MohamedFola/ADAS-Graduation-Project/STM32F103x pinout.jpeg

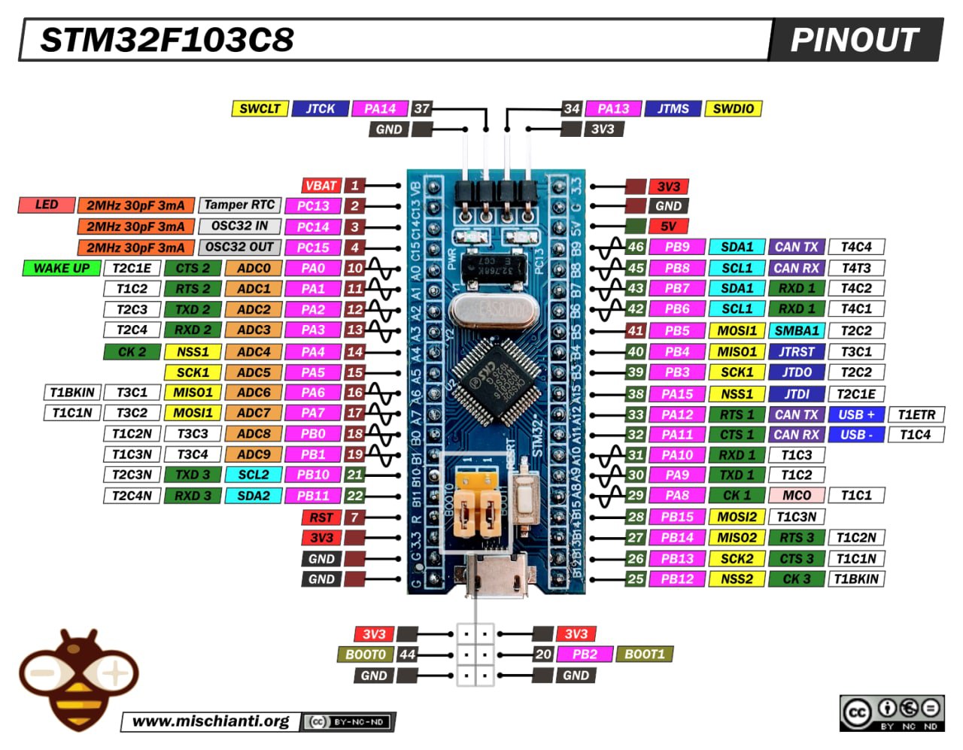
STM32F103x pinout.jpeg
