MohamedFola/ADAS-Graduation-Project/PCBs/Motion/Motion_board2.pdf

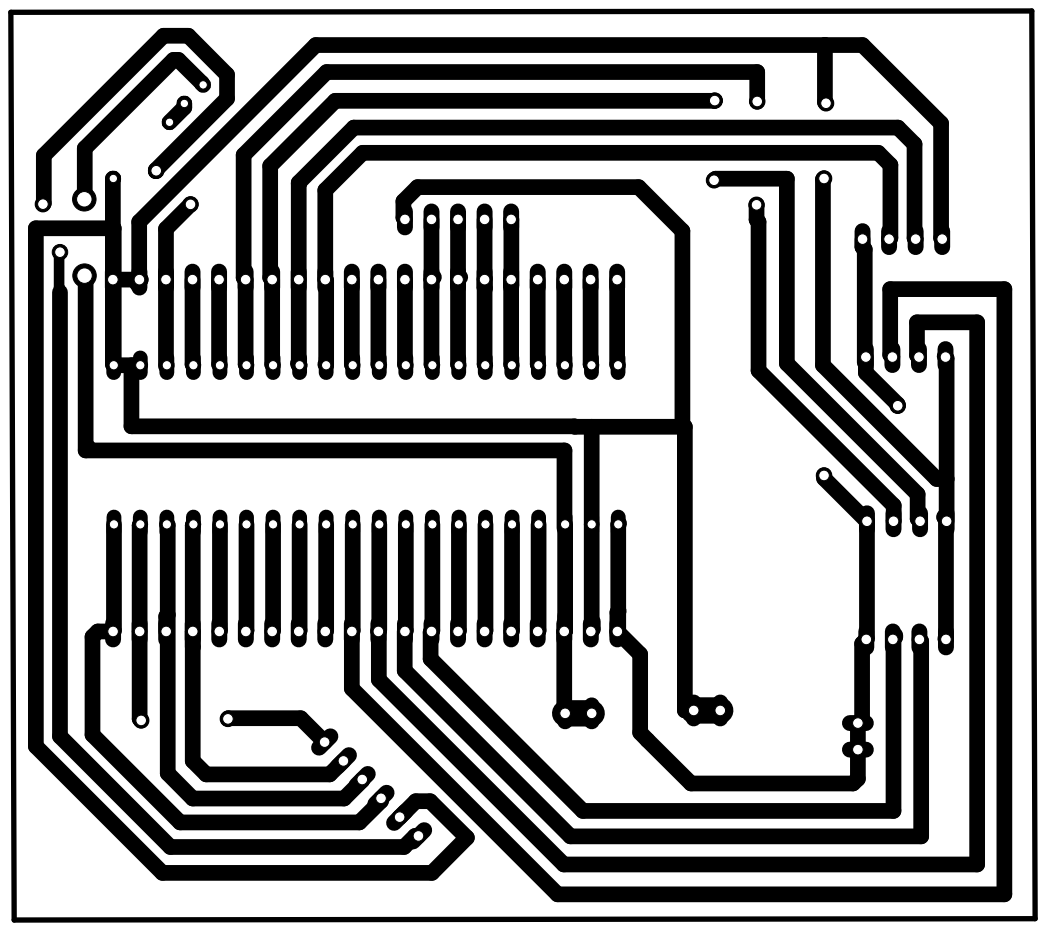
[picture p11: page 1]
