MohamedFola/ADAS-Graduation-Project/PCBs/Motion/Motion_sticker_2.pdf

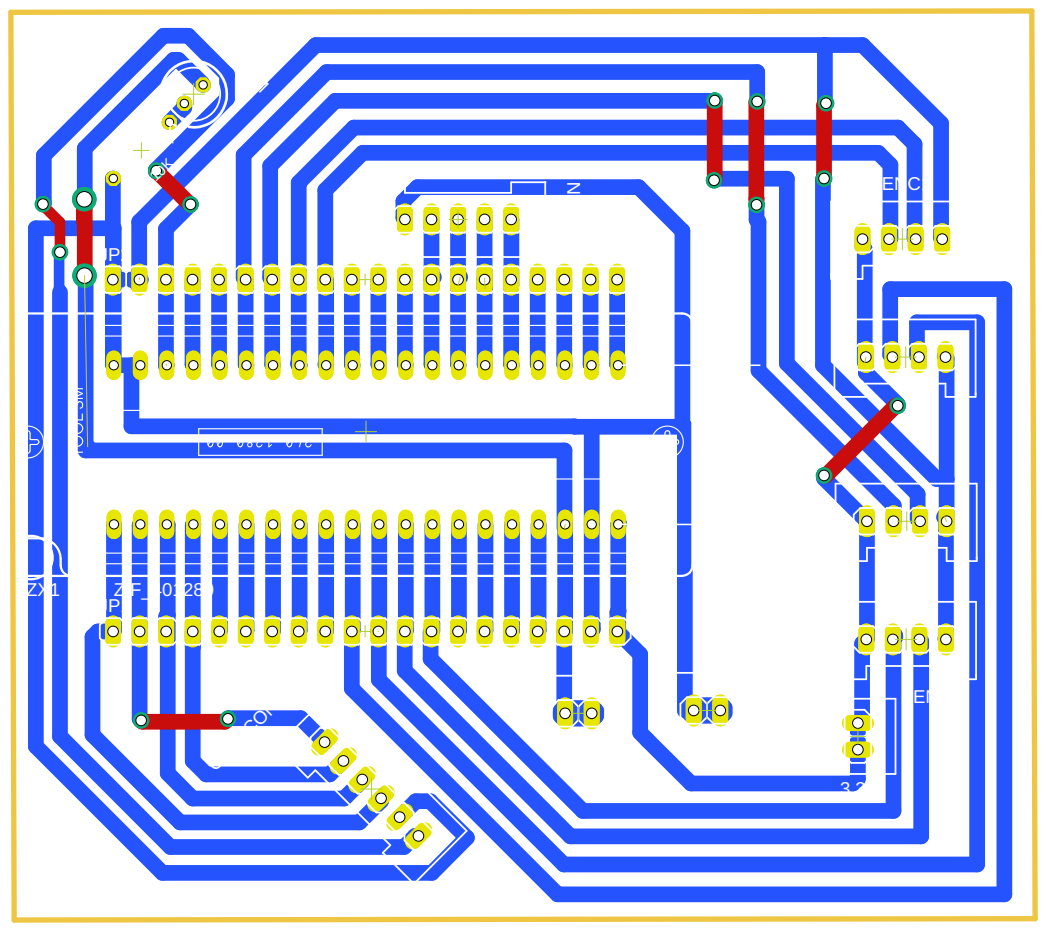
[picture p12: page 1]
