MohamedFola/ADAS-Graduation-Project/PCBs/Power1/Power_boarddd.pdf

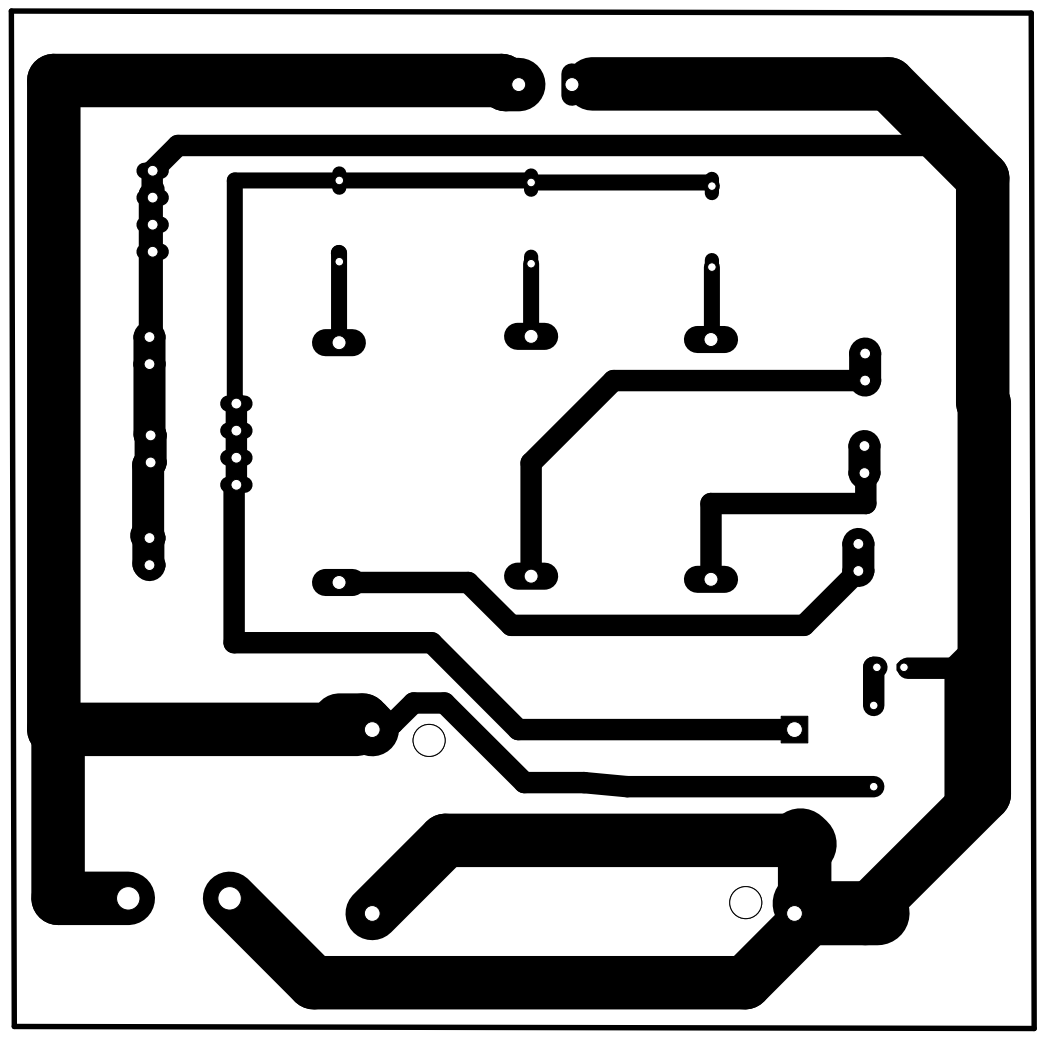
[picture p13: page 1]
