MohamedFola/ADAS-Graduation-Project/PCBs/Power1/Power_stickerrr.pdf

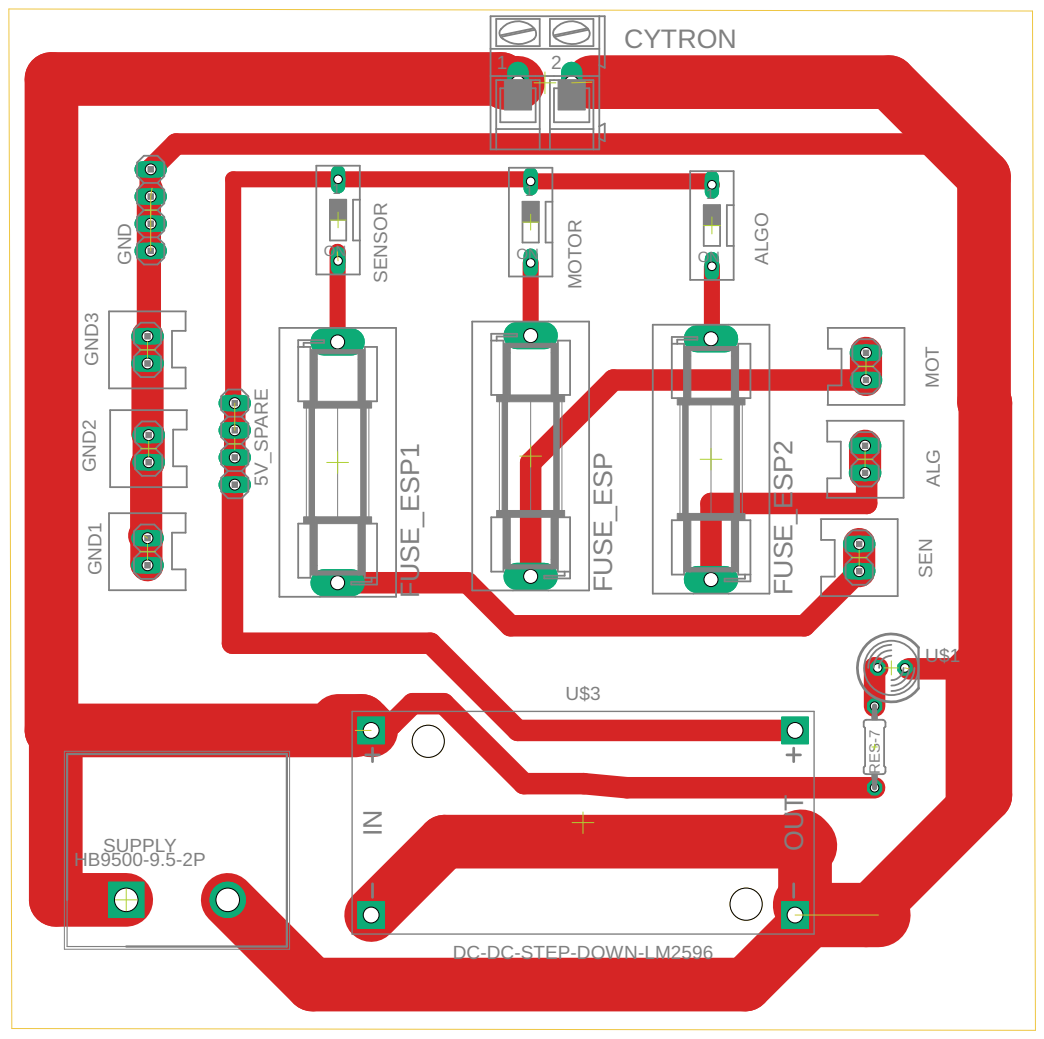
[picture p14: page 1]

DC-DC-STEP-DOWN-LM2596
