MohamedFola/ADAS-Graduation-Project/PCBs/Power1/Power_stickerrrrr.pdf

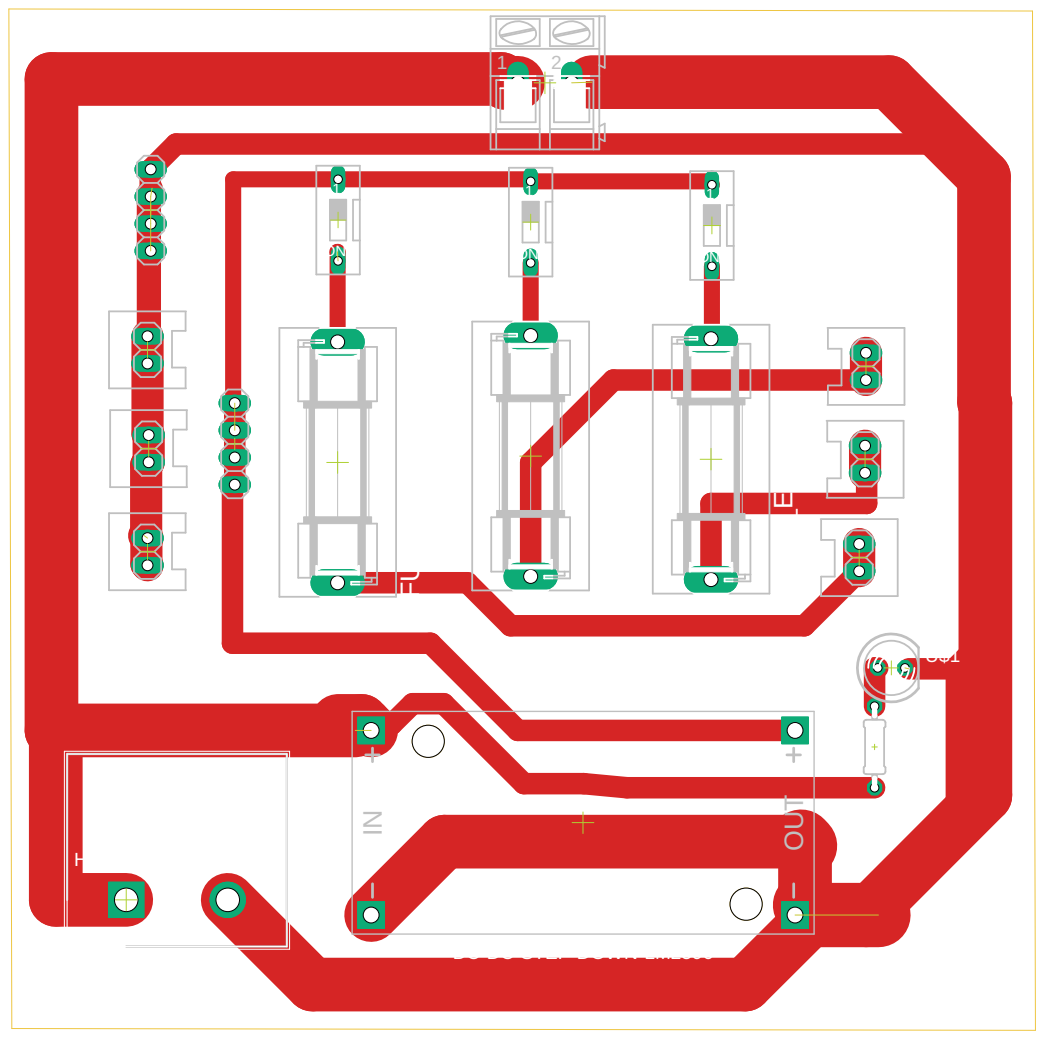
[picture p15: page 1]

DC-DC-STEP-DOWN-LM2596
