MohamedFola/ADAS-Graduation-Project/PCBs/Motion/Motion_board.pdf

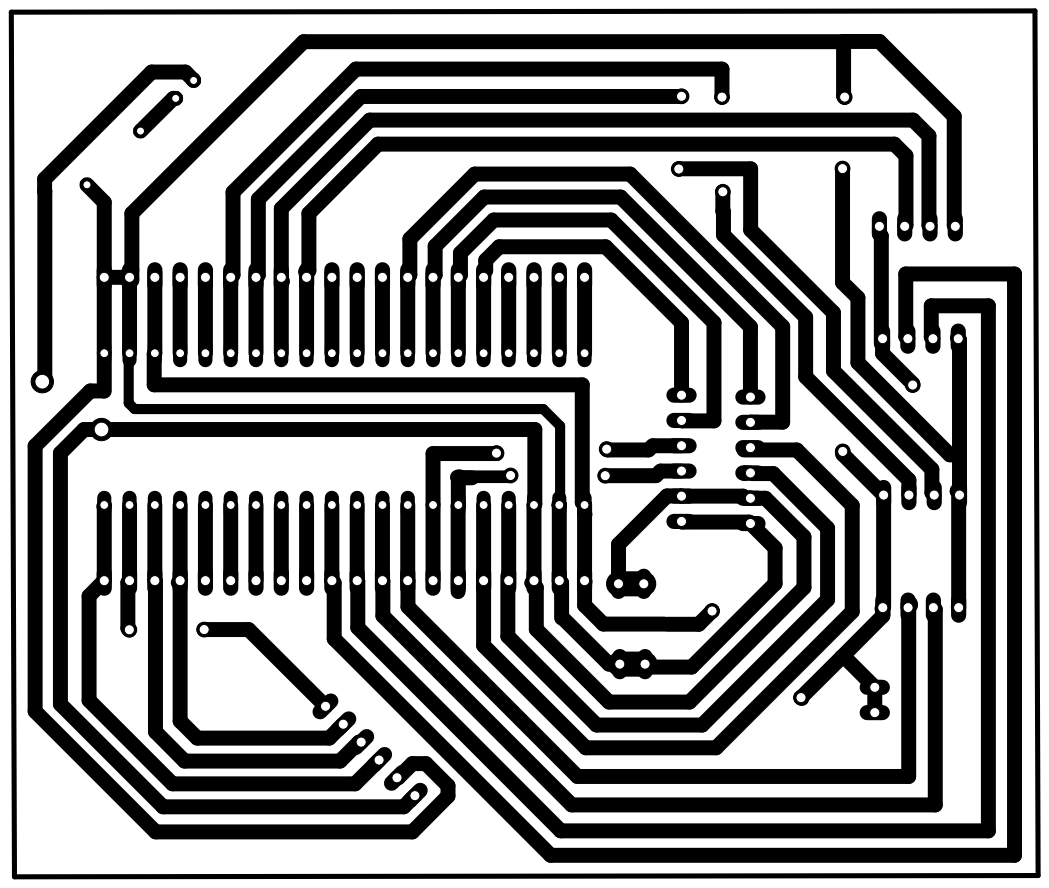
[picture p16: page 1]
