MohamedFola/ADAS-Graduation-Project/PCBs/Motion/Motion_stk.pdf

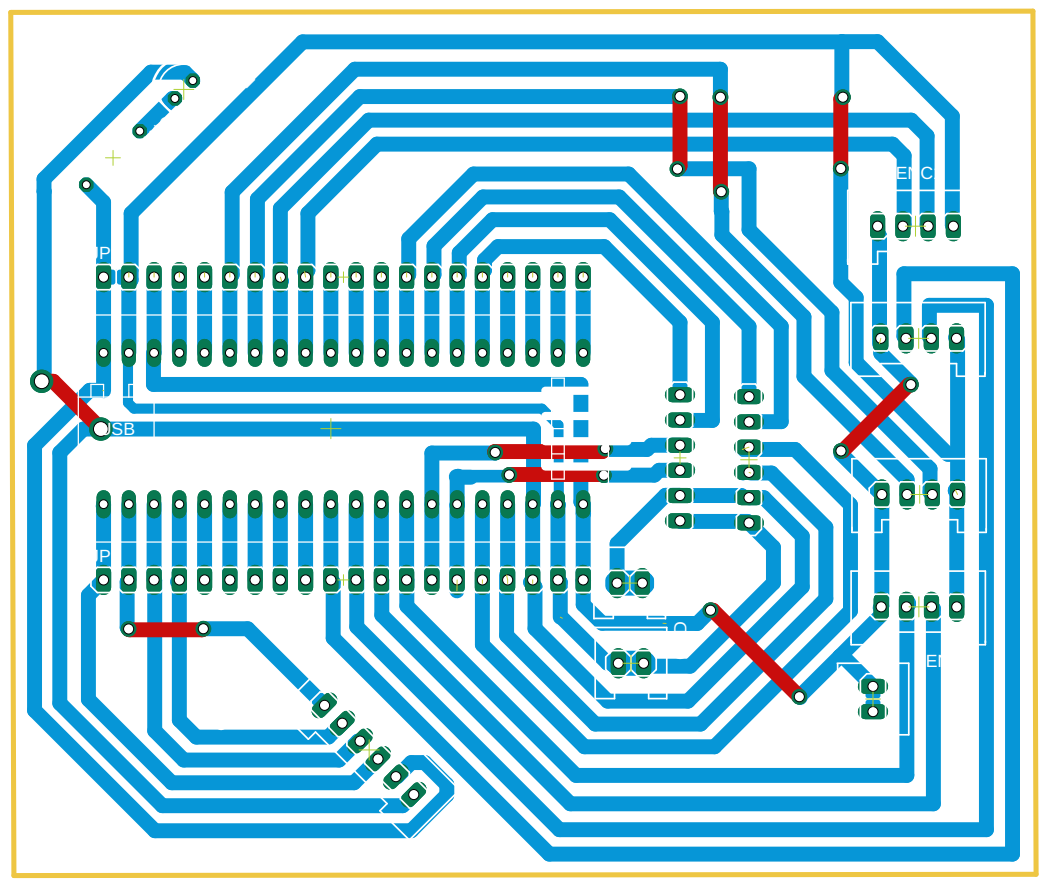
[picture p17: page 1]
