MohamedFola/ADAS-Graduation-Project/PCBs/Power1/Power_grad.pdf

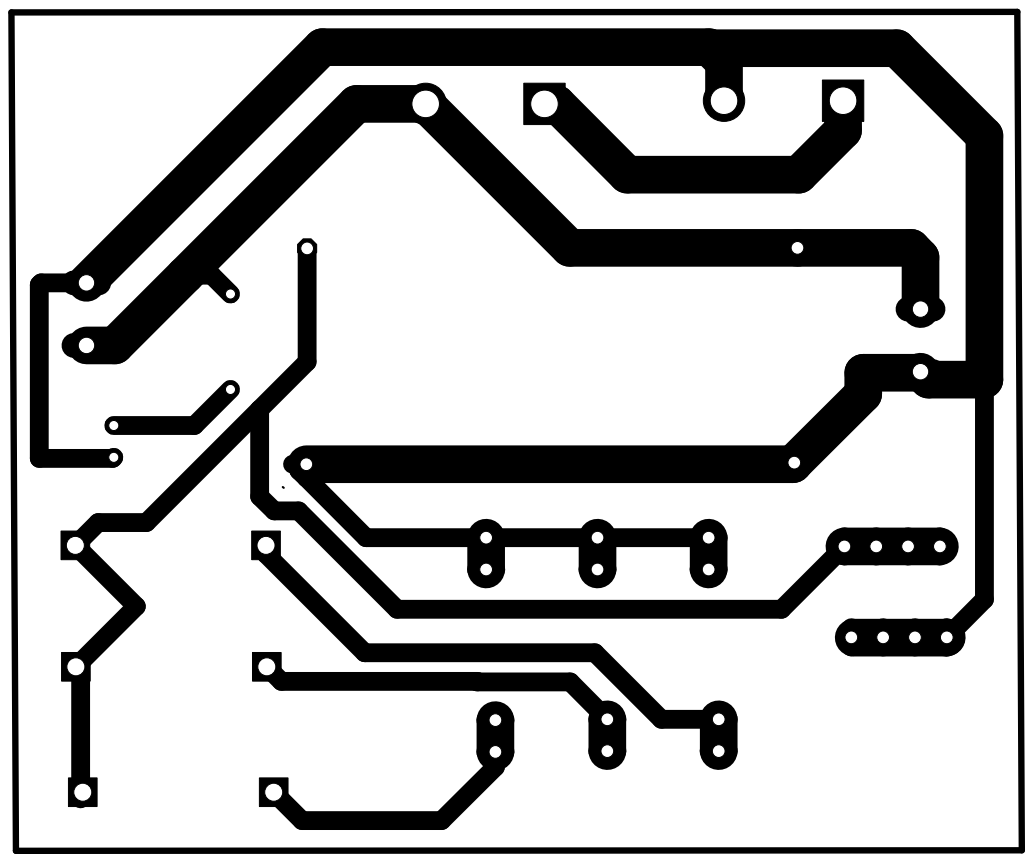
[picture p18: page 1]
