MohamedFola/ADAS-Graduation-Project/PCBs/Power1/Power_grad_stc.pdf

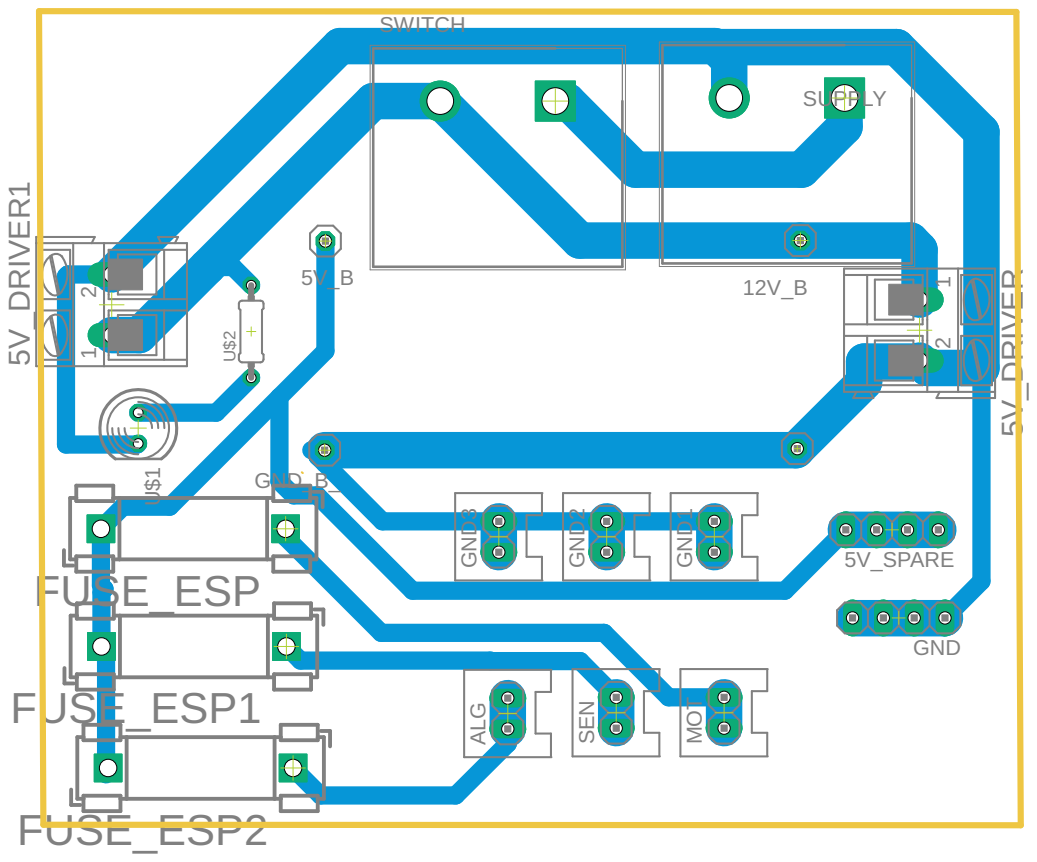
[picture p19: page 1]
