MohamedFola/ADAS-Graduation-Project/PCBs/Ultrasonic board/Ultrasonic.pdf

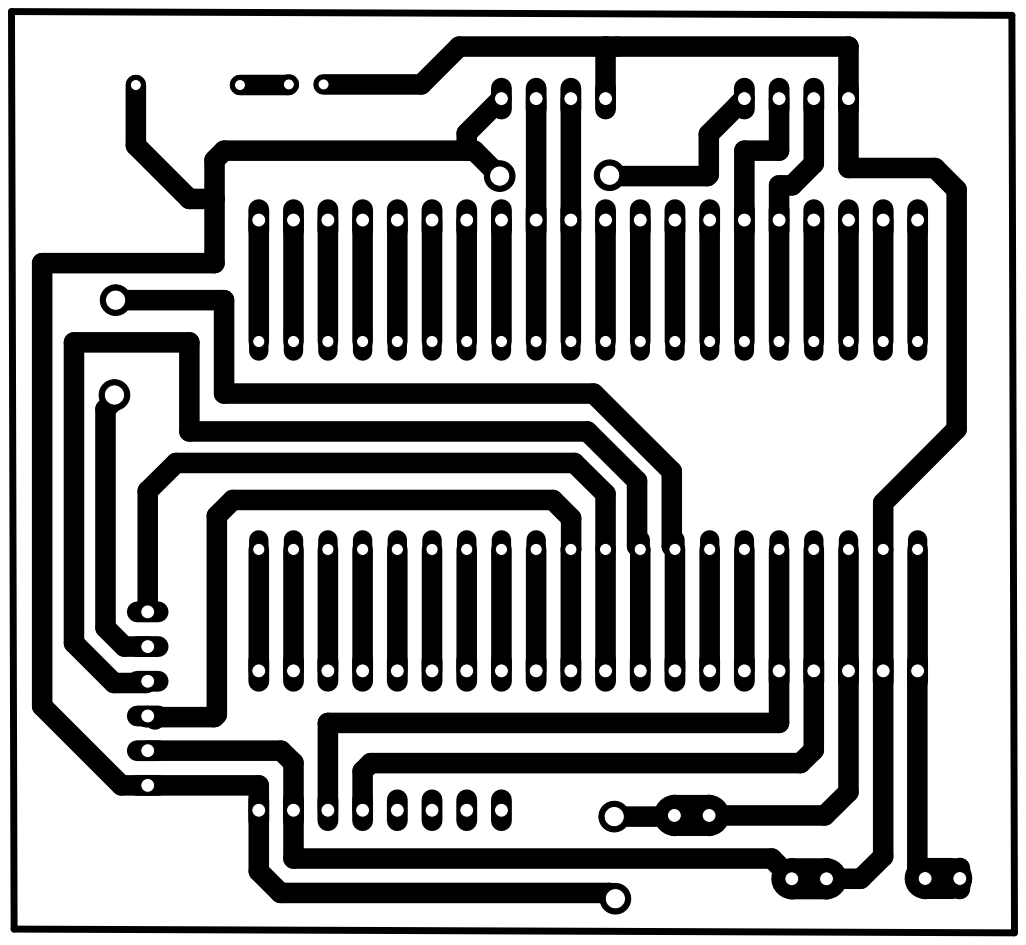
[picture p20: page 1]
