MohamedFola/ADAS-Graduation-Project/PCBs/Motion/Motion_2.brd

## EAGLE design PCBs/Motion/Motion_2.brd (2023-04-24)

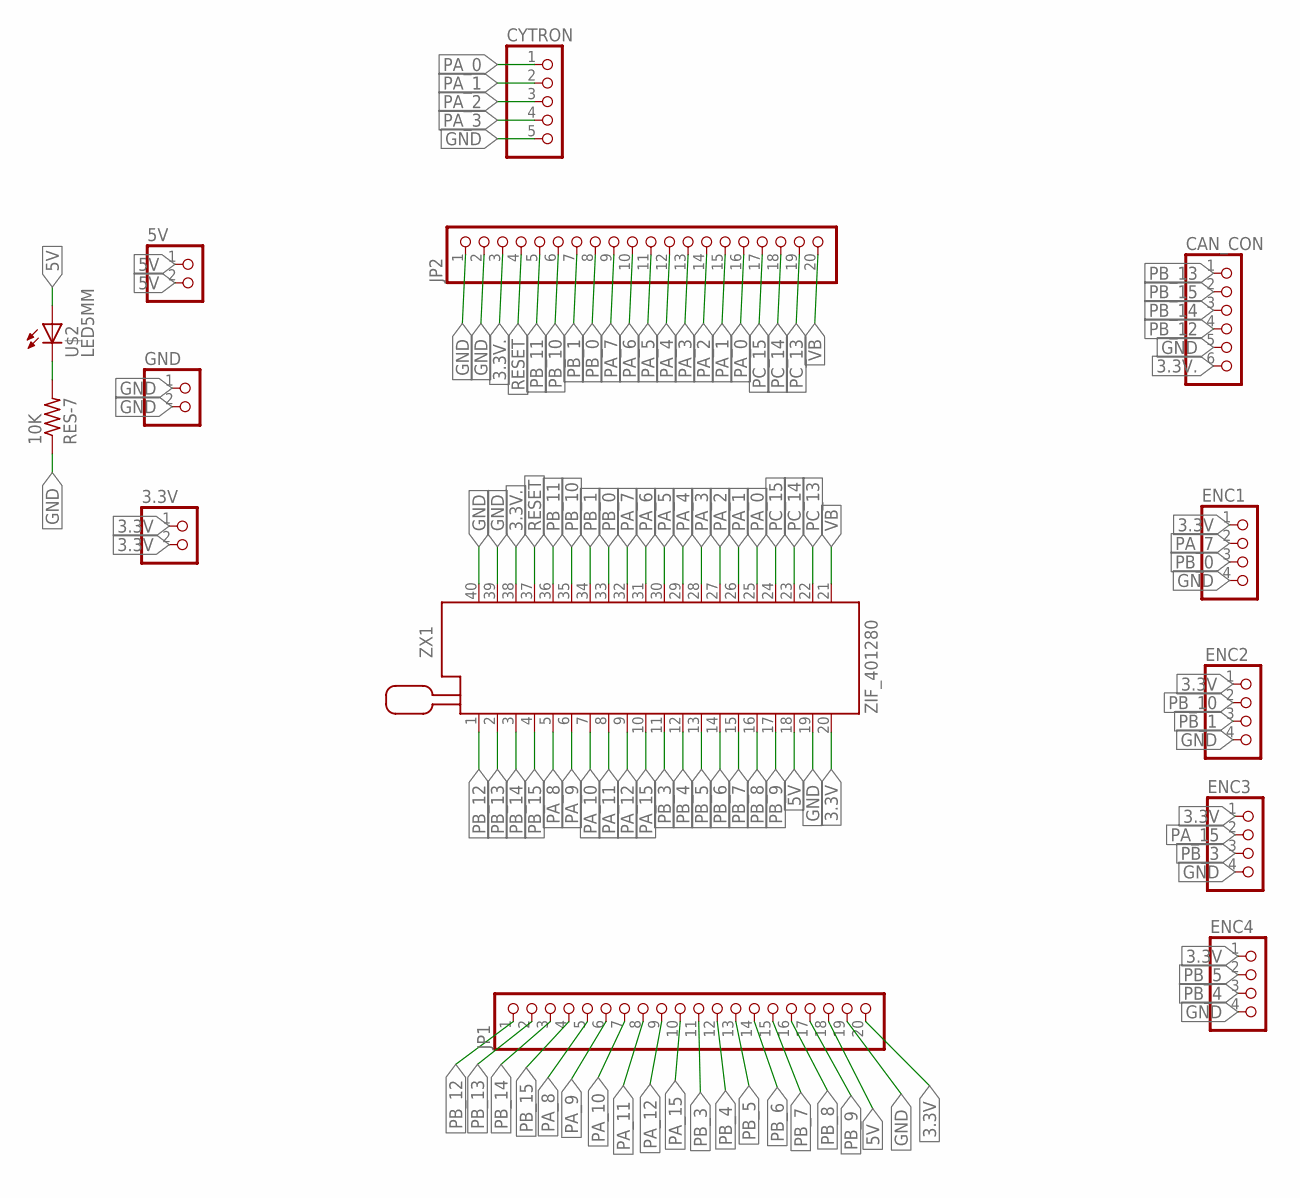
[picture p21: schematic Motion_2.sch]

Parts:
3.3V, 5V: PINHD-2_DATA; 1X02_DATA
10K: RES-7; 0204/7
CAN_CON: PINHD-6_DATA; 1X06_DATA
CYTRON: PINHD-5_DATA; 1X05_DATA
ENC1, ENC2, ENC3, ENC4: PINHD-4_DATA; 1X04_DATA
GND: PINHD-2_DATA; 1X02_DATA
JP1, JP2: PINHD-1X20; 1X20
U$2: LED5MM
ZX1: ZIF_401280; 240-1280-00-0602J

Connections:
3.3V: 3.3V.1, 3.3V.2, ENC1.1, ENC2.1, ENC3.1, ENC4.1, JP1.20, ZX1.20
3.3V.: CAN_CON.6, JP2.3, ZX1.38
5V: 5V.1, 5V.2, JP1.18, U$2.A, ZX1.18
GND: 10K.1, CAN_CON.5, CYTRON.5, ENC1.4, ENC2.4, ENC3.4, ENC4.4, GND.1, GND.2, JP1.19, JP2.1, JP2.2, ZX1.19, ZX1.39, ZX1.40
unnamed: 10K.2, U$2.K (C)
PA_0: CYTRON.1, JP2.16, ZX1.25
PA_1: CYTRON.2, JP2.15, ZX1.26
PA_2: CYTRON.3, JP2.14, ZX1.27
PA_3: CYTRON.4, JP2.13, ZX1.28
PA_4: JP2.12, ZX1.29
PA_5: JP2.11, ZX1.30
PA_6: JP2.10, ZX1.31
PA_7: ENC1.2, JP2.9, ZX1.32
PA_8: JP1.5, ZX1.5
PA_9: JP1.6, ZX1.6
PA_10: JP1.7, ZX1.7
PA_11: JP1.8, ZX1.8
PA_12: JP1.9, ZX1.9
PA_15: ENC3.2, JP1.10, ZX1.10
PB_0: ENC1.3, JP2.8, ZX1.33
PB_1: ENC2.3, JP2.7, ZX1.34
PB_3: ENC3.3, JP1.11, ZX1.11
PB_4: ENC4.3, JP1.12, ZX1.12
PB_5: ENC4.2, JP1.13, ZX1.13
PB_6: JP1.14, ZX1.14
PB_7: JP1.15, ZX1.15
PB_8: JP1.16, ZX1.16
PB_9: JP1.17, ZX1.17
PB_10: ENC2.2, JP2.6, ZX1.35
PB_11: JP2.5, ZX1.36
PB_12: CAN_CON.4, JP1.1, ZX1.1
PB_13: CAN_CON.1, JP1.2, ZX1.2
PB_14: CAN_CON.3, JP1.3, ZX1.3
PB_15: CAN_CON.2, JP1.4, ZX1.4
PC_13: JP2.19, ZX1.22
PC_14: JP2.18, ZX1.23
PC_15: JP2.17, ZX1.24
RESET: JP2.4, ZX1.37
VB: JP2.20, ZX1.21

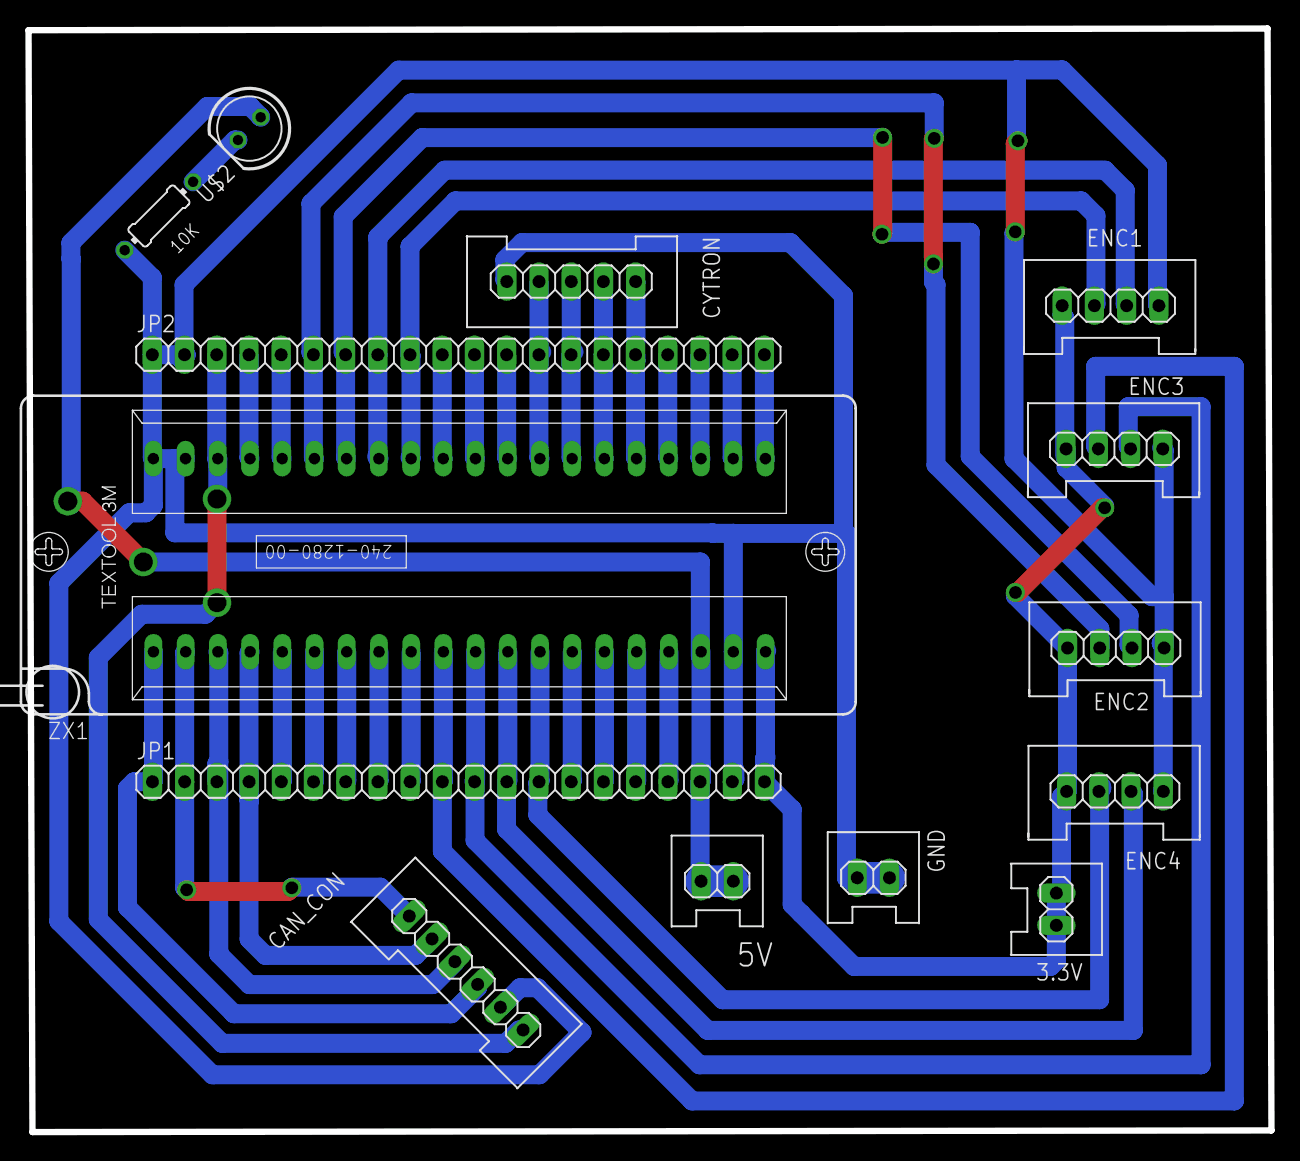
[picture p22: board Motion_2.brd from above]

Board: 2 copper layers, 98.0 x 87.0 mm, 14 parts (0 on the bottom side), 39 nets.
