MohamedFola/ADAS-Graduation-Project/PCBs/Power1/Power_grad.brd

## EAGLE design PCBs/Power1/Power_grad.brd (2023-04-24)

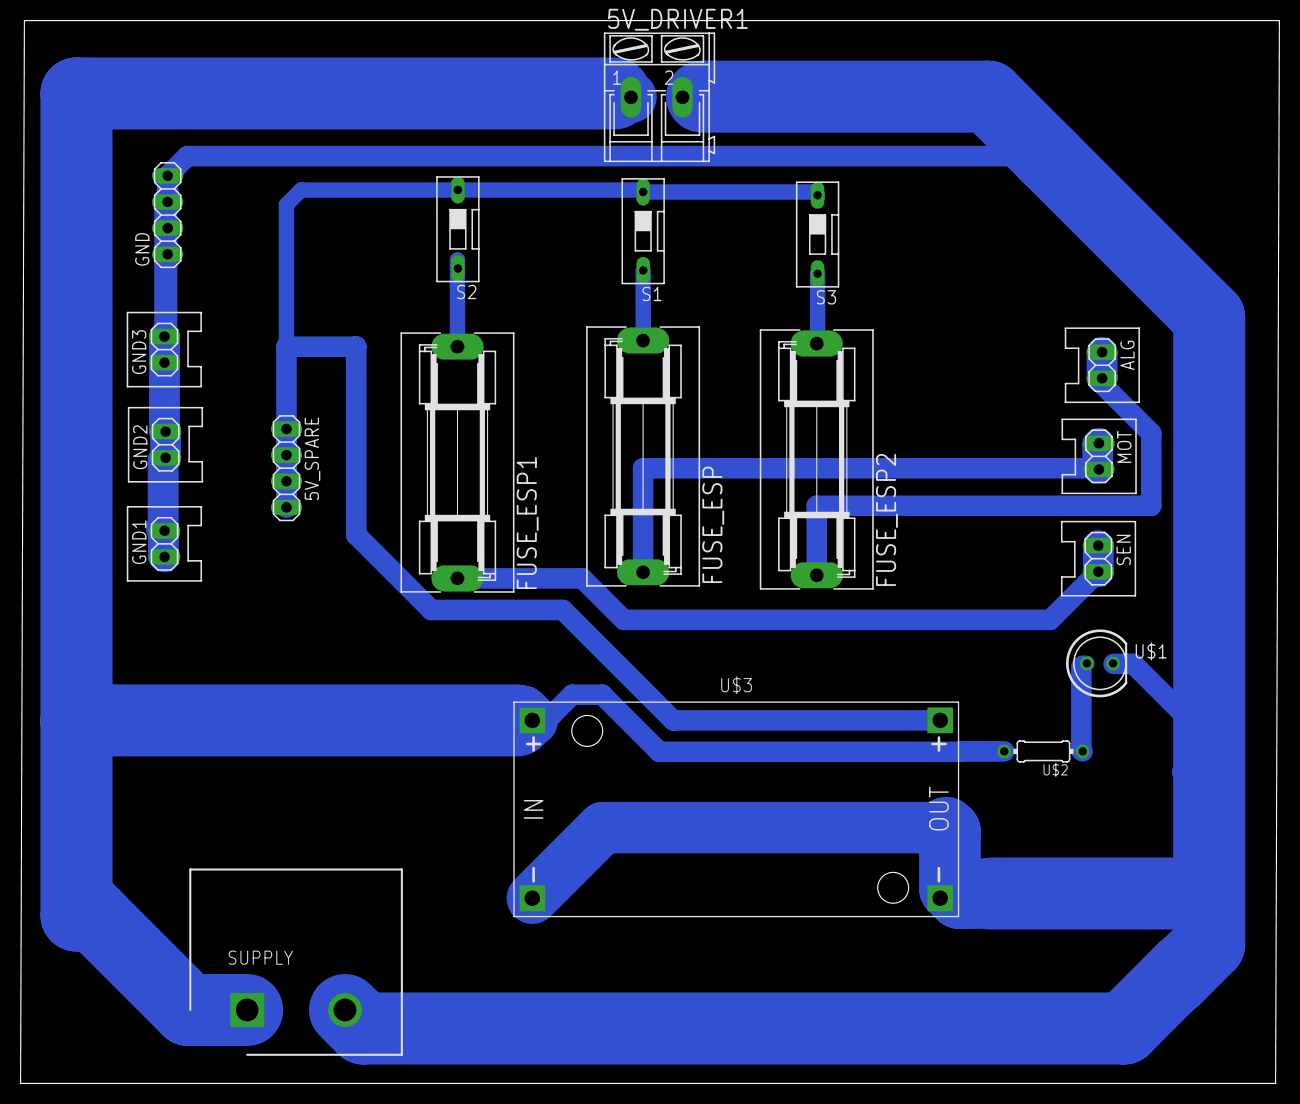
[picture p23: board Power_grad.brd from above]

Board: 2 copper layers, 122.3 x 103.2 mm, 19 parts (0 on the bottom side), 10 nets.

Parts:
5V_DRIVER1: AK300/2
5V_SPARE: 1X04
ALG: 1X02_DATA
FUSE_ESP, FUSE_ESP1, FUSE_ESP2: SH22,5A
GND: 1X04
GND1, GND2, GND3: 1X02_DATA
MOT: 1X02_DATA
S1, S2, S3: DS-01
SEN: 1X02_DATA
SUPPLY: HB9500-9.5-2P; SHDR2W140P0X950_1X2_2055X1800X
U$1: LED5MM
U$2: RES-7; 0204/7
U$3: DC-DC-STEP-DOWN-LM2596

Connections:
5V: 5V_SPARE.1, 5V_SPARE.2, 5V_SPARE.3, 5V_SPARE.4, S1.1, S2.1, S3.1, U$3.OUT+
12V: 5V_DRIVER1.1, SUPPLY.1, U$2.2, U$3.IN+
ALG: ALG.1, ALG.2, FUSE_ESP2.1
GND: 5V_DRIVER1.2, GND.1, GND.2, GND.3, GND.4, GND1.1, GND1.2, GND2.1, GND2.2, GND3.1, GND3.2, SUPPLY.2, U$1.K, U$3.IN-, U$3.OUT-
MOT: FUSE_ESP.1, MOT.1, MOT.2
unnamed: U$1.A, U$2.1
unnamed: FUSE_ESP1.2, S2.2
unnamed: FUSE_ESP.2, S1.2
unnamed: FUSE_ESP2.2, S3.2
SEN: FUSE_ESP1.1, SEN.1, SEN.2
