MohamedFola/ADAS-Graduation-Project/PCBs/Ultrasonic board/Ultrasonic.brd

## EAGLE design PCBs/Ultrasonic board/Ultrasonic.brd (2023-03-12)

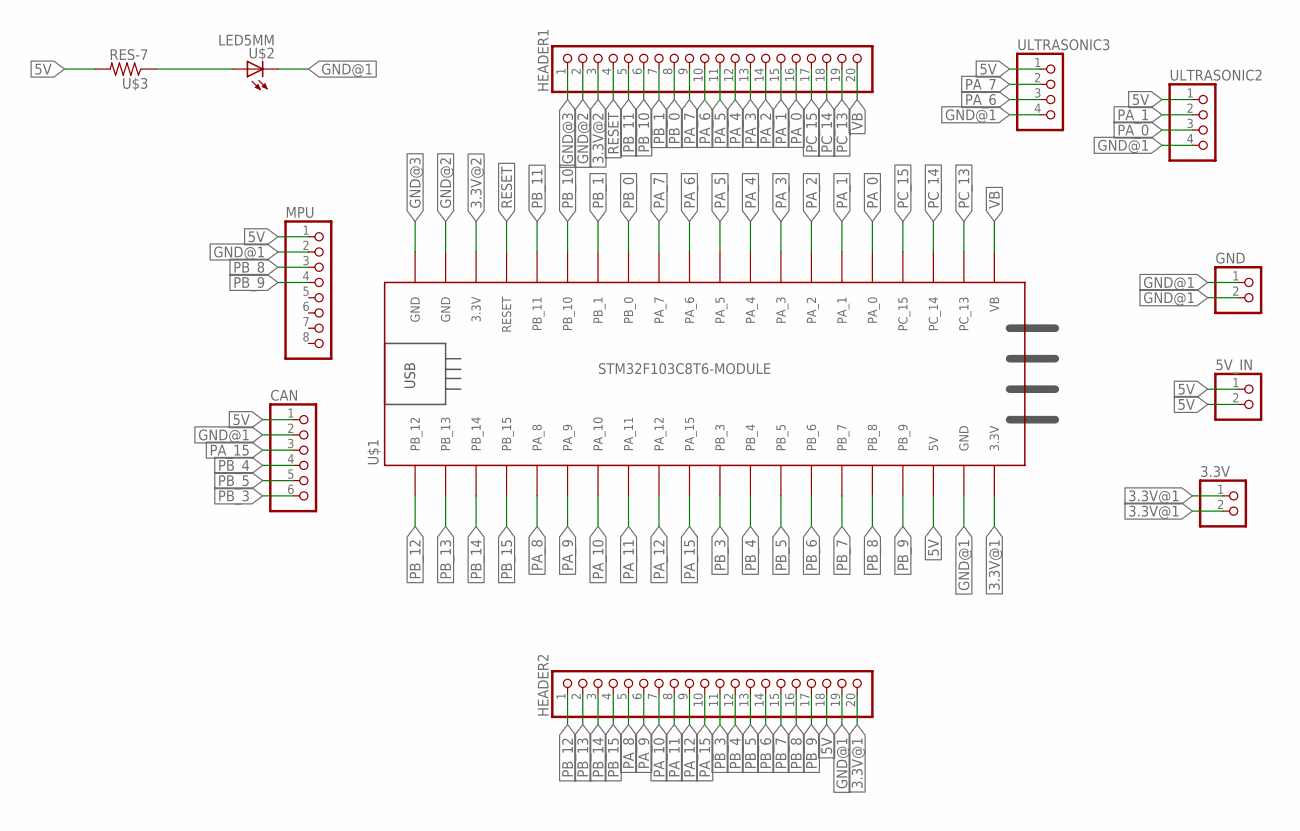
[picture p24: schematic Ultrasonic.sch]

Parts:
3.3V, 5V_IN: PINHD-2_DATA; 1X02_DATA
CAN: PINHD-6_DATA; 1X06_DATA
GND: PINHD-2_DATA; 1X02_DATA
HEADER1, HEADER2: PINHD-1X20; 1X20
MPU: PINHD-1X8; 1X08
U$1: STM32F103C8T6-MODULE
U$2: LED5MM
U$3: RES-7; 0204/7
ULTRASONIC2, ULTRASONIC3: PINHD-4_DATA; 1X04_DATA

Connections:
3.3V@1: 3.3V.1, 3.3V.2, HEADER2.20, U$1.3.3V_1 (3.3V)
3.3V@2: HEADER1.3, U$1.3.3V_2 (3.3V)
5V: 5V_IN.1, 5V_IN.2, CAN.1, HEADER2.18, MPU.1, U$1.5V, U$3.2, ULTRASONIC2.1, ULTRASONIC3.1
GND@1: CAN.2, GND.1, GND.2, HEADER2.19, MPU.2, U$1.GND_1 (GND), U$2.K (C), ULTRASONIC2.4, ULTRASONIC3.4
GND@2: HEADER1.2, U$1.GND_2 (GND)
GND@3: HEADER1.1, U$1.GND_3 (GND)
unnamed: U$2.A, U$3.1
PA_0: HEADER1.16, U$1.PA_0, ULTRASONIC2.3
PA_1: HEADER1.15, U$1.PA_1, ULTRASONIC2.2
PA_2: HEADER1.14, U$1.PA_2
PA_3: HEADER1.13, U$1.PA_3
PA_4: HEADER1.12, U$1.PA_4
PA_5: HEADER1.11, U$1.PA_5
PA_6: HEADER1.10, U$1.PA_6, ULTRASONIC3.3
PA_7: HEADER1.9, U$1.PA_7, ULTRASONIC3.2
PA_8: HEADER2.5, U$1.PA_8
PA_9: HEADER2.6, U$1.PA_9
PA_10: HEADER2.7, U$1.PA_10
PA_11: HEADER2.8, U$1.PA_11
PA_12: HEADER2.9, U$1.PA_12
PA_15: CAN.3, HEADER2.10, U$1.PA_15
PB_0: HEADER1.8, U$1.PB_0
PB_1: HEADER1.7, U$1.PB_1
PB_3: CAN.6, HEADER2.11, U$1.PB_3
PB_4: CAN.4, HEADER2.12, U$1.PB_4
PB_5: CAN.5, HEADER2.13, U$1.PB_5
PB_6: HEADER2.14, U$1.PB_6
PB_7: HEADER2.15, U$1.PB_7
PB_8: HEADER2.16, MPU.3, U$1.PB_8
PB_9: HEADER2.17, MPU.4, U$1.PB_9
PB_10: HEADER1.6, U$1.PB_10
PB_11: HEADER1.5, U$1.PB_11
PB_12: HEADER2.1, U$1.PB_12
PB_13: HEADER2.2, U$1.PB_13
PB_14: HEADER2.3, U$1.PB_14
PB_15: HEADER2.4, U$1.PB_15
PC_13: HEADER1.19, U$1.PC_13
PC_14: HEADER1.18, U$1.PC_14
PC_15: HEADER1.17, U$1.PC_15
RESET: HEADER1.4, U$1.RESET
VB: HEADER1.20, U$1.VB

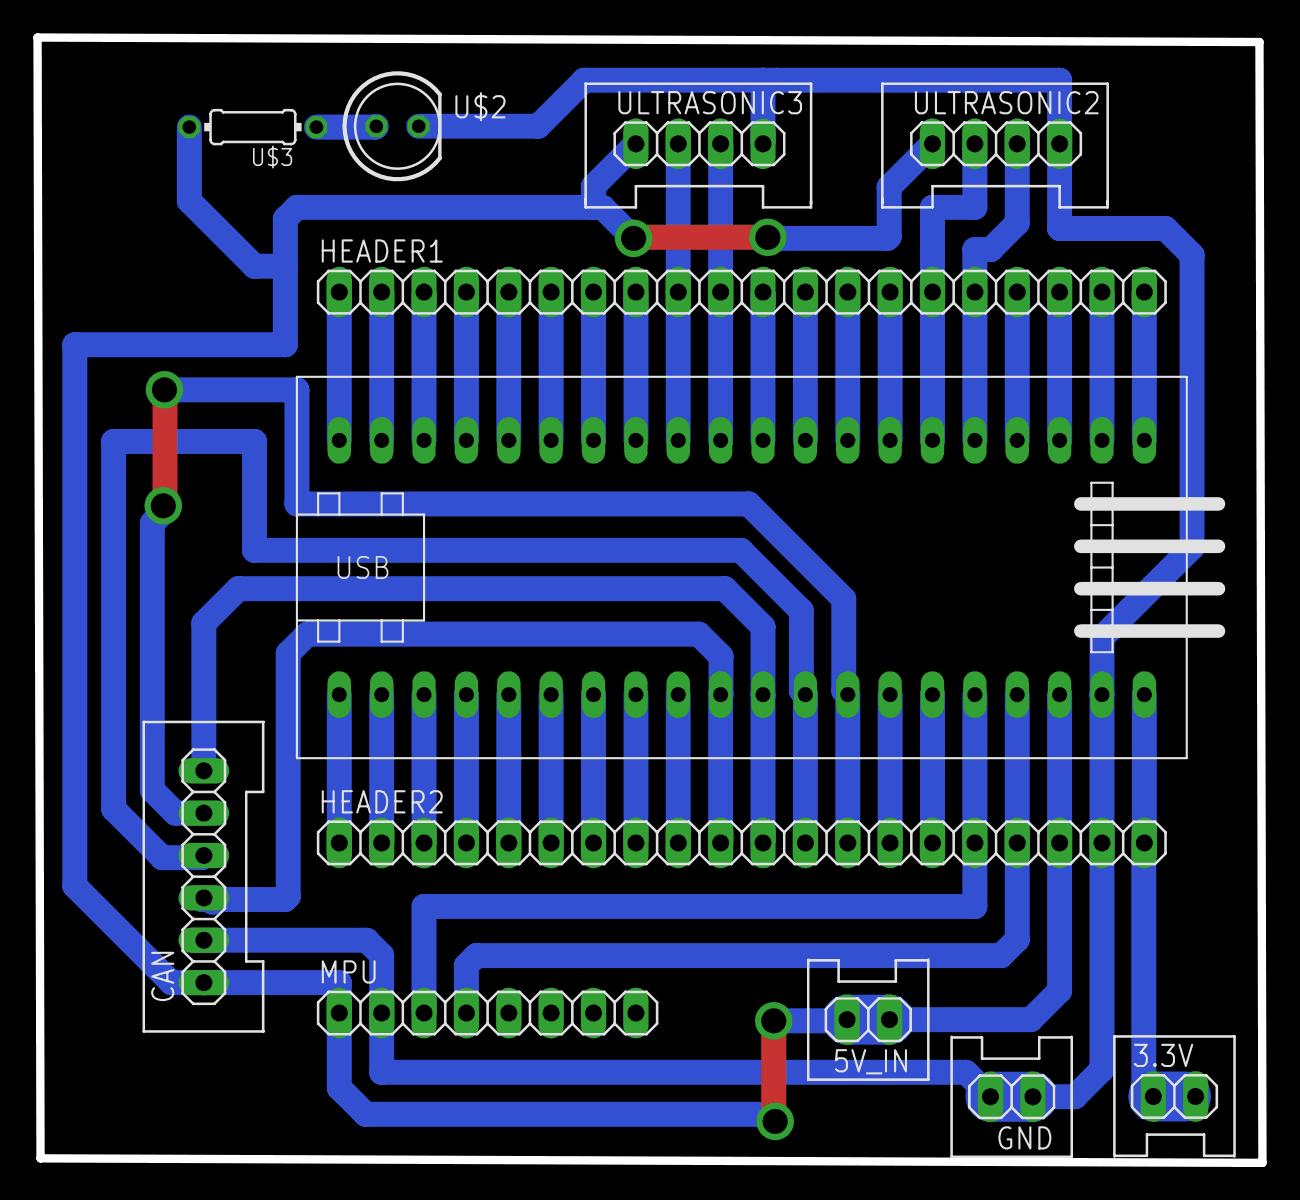
[picture p25: board Ultrasonic.brd from above]

Board: 2 copper layers, 73.4 x 67.5 mm, 12 parts (0 on the bottom side), 41 nets.
