MohamedFola/ADAS-Graduation-Project/ARM_Driver/01-MCAL/00-RCC/RCC_interface.h

/*
 * RCC_int.h
 *
 *  Created on: Dec 27, 2022
 *      Author: LapStore
 */

#ifndef MCAL_RCC_RCC_INTERFACE_H_
#define MCAL_RCC_RCC_INTERFACE_H_

//Macros to choose which bus the peripheral connected on it
#define	RCC_AHB		0
#define RCC_APB1	1
#define RCC_APB2	2

//Peripherals you choose when you enable it for APB2 bus
#define RCC_AFIO 	0
#define RCC_GPIOA 	2
#define RCC_GPIOB 	3
#define RCC_GPIOC 	4
#define RCC_GPIOD	5
#define RCC_GPIOE	6
#define RCC_GPIOF	7
#define RCC_GPIOG	8
#define RCC_ADC1	9
#define RCC_ADC2	10
#define RCC_TIM1	11
#define RCC_SPI1	12
#define RCC_TIM8	13
#define RCC_USART1	14
#define RCC_ADC3	15
#define RCC_TIM9	19
#define RCC_TIM10	20
#define RCC_TIM11	21

//Peripherals you choose when you enable it for APB1 bus
#define RCC_TIM2    0
#define RCC_TIM3    1
#define RCC_TIM4    2
#define RCC_TIM5    3
#define RCC_TIM6    4
#define RCC_TIM7   	5
#define RCC_TIM12	6
#define RCC_TIM13   7
#define RCC_TIM14   8
#define RCC_WWDG   	11
#define RCC_SPI2    14
#define RCC_SPI3    15
#define RCC_USART2  17
#define RCC_USART3  18
#define RCC_USART4  19
#define RCC_USART5  20
#define RCC_I2C1    21
#define RCC_I2C2    22
#define RCC_USB     23
#define RCC_CAN     25
#define RCC_BKP     27
#define RCC_PWR     28
#define RCC_DAC     29

//Peripherals you choose when you enable it for AHB bus
#define RCC_DMA1	0
#define RCC_DMA2	1
#define RCC_SRAM	2
#define RCC_FLITF	4
#define RCC_CRCE	6
#define RCC_FSMC	8
#define RCC_SDIO	10


void RCC_voidInitSysClock(void);

u8 RCC_voidEnableClock(u8 Copy_u8PeripheralID,u8 Copy_u8BusId);

u8 RCC_voidDisableClock(u8 Copy_u8PeripheralID,u8 Copy_u8BusId);

#endif /* MCAL_RCC_RCC_INT_H_ */
