MohamedFola/ADAS-Graduation-Project/ARM_Driver/01-MCAL/01-PORT/PORT_interface.h

/***************************************************************/
/*             Author  : Mohamed Hassan Hassan                 */
/*             Layer   : MCAL                                  */
/*             Version : 1                                     */
/*             SWC     : Port Driver                           */
/***************************************************************/

#ifndef _PORT_INTERFACE_H_
#define _PORT_INTERFACE_H_


/****************************************************************************
 * Name        : PORT_voidInit                                              *
 *                                                                          *
 * Return type : void                                                       *
 *                                                                          *
 * Arguments   : void                                                       *
 * 	                                                                        *
 * Type        : Synchronous & Non Reentrant                                *
 *                                                                          *
 * description : Initiate all Pins of the Microcontroller                   *
 ****************************************************************************/
void PORT_voidInit( void );

#endif /* _PORT_INTERFACE_H_ */
