MohamedFola/ADAS-Graduation-Project/(commit log)

2022-12-30 Add files via upload
    First Commit for ARM Drivers --> BIT_MATH.h & STD_TYPES.h & Software_Delay.c & Software_Delay.h
2022-12-30 First Commit For ARM Drivers
    Included files: Bit manipulation header file & Standard types header files & Software delay Driver
2022-12-30 First Commit for ARM drivers
    Included files are BIT_MATH.h, STD_TYPES.h, Software_Delay.h and Software_Delay.c
2022-12-30 References for Cortex M3 -> STM32F10xx
    Programming Manual, Register Description, and Technical Reference Manual
2023-01-31 PORT Driver first commit -- Mohamed Hassan
2023-02-02 Modified RCC program and fixed some errors
    [RCC_interface.h, RCC_program.c]
2023-02-07 I2C Driver first commit by Fola
2023-02-09 Adding NVIC Driver
2023-02-09 Adding EXTI Driver
2023-02-09 Adding AFIO Driver
2023-02-10 Add files via upload
    TIMER WORKING BUT SET PERIODIC AND SINGLE INTERVAL NEEDS TO BE REVISED
2023-02-15 Improving Driver
2023-02-17 SPI Driver implementation by Fola
2023-02-17 adding some IMOPRTANT notes for spi driver
2023-02-17 PWM v1 tested
2023-03-03 Encoder implementation v1
2023-03-03 Encoder v1
2023-03-07 Adding PWM4
2023-03-08 Motion board v1
    [Motion.brd, Motion.sch]
2023-03-09 Ultrasonic ready to work but there is fluctiations
2023-03-12 Added Ultrasonic & Power PCBs
    [Power_grad.brd, Power_grad.sch, Ultrasonic.brd, Ultrasonic.sch]
2023-03-20 Motor driver need to be tested
2023-03-22 fixing bugs and testing I2C and SPI
2023-04-10 Motor motion driver
2023-04-12 Power modify
    [Power_grad.brd, Power_grad.sch]
2023-04-12 adding init files and fixing some bugs
    [init.c, init.config.h, init.h]
2023-04-24 PID v1.0
    [Motion_2.brd, Motion_2.sch, Power_grad.brd, Power_grad2.brd, Power_grad2.sch]
2023-04-24 PID v1
2023-05-03 SPI fixing bugs and adding test project
2023-05-05 UART v1
2023-05-05 UART v1.0
2023-05-09 Updating Ultrasonic
2023-05-19 Updating drivers
2023-05-21 Added comm handler driver
2023-05-24 CommHandler and some drivers Update
2023-06-30 adding boards codes
2023-07-06 adding a zip file that contains all codes of the board
